NikitaSM5/FPGA_Automotive_Radar/(list of files, drawings)

Other design files:
Altium design/ADC.SchDoc
Altium design/Flash.SchDoc
Altium design/FPGA.SchDoc
Altium design/FPGA_Automotibe_Radar_Lib.SchLib
Altium design/FPGA_Automotive_Radar.PrjPcb
Altium design/FPGA_Automotive_Radar_PcbLib.PcbLib
Altium design/PCB2.PcbDoc
Altium design/PCB3.PcbDoc
Altium design/Power.SchDoc
