NikitaSM5/FPGA_Automotive_Radar/(commit log)

2025-09-28 PCB no traces
    [ADC.SchDoc, FPGA_Automotibe_Radar_Lib.SchLib, FPGA_Automotive_Radar_PcbLib.PcbLib, Flash.SchDoc, PCB3.PcbDoc, Power.SchDoc]
2025-09-28 Типа начал разводить
    [FPGA_Automotibe_Radar_Lib.SchLib, FPGA_Automotive_Radar_PcbLib.PcbLib, PCB3.PcbDoc, Power.SchDoc]
2025-09-28 Трассировка v1
    [PcbLib1.PcbLib]
2025-09-29 Трассировка v2
    [FPGA_Automotibe_Radar_Lib.SchLib, FPGA_Automotive_Radar_PcbLib.PcbLib, PCB3.PcbDoc, Power.SchDoc]
2025-10-03 Трассировка
    [ADC.SchDoc, FPGA_Automotibe_Radar_Lib.SchLib, FPGA_Automotive_Radar.PrjPcb, FPGA_Automotive_Radar_PcbLib.PcbLib, Flash.SchDoc, Power.SchDoc]
2025-10-14 Чертеж платы печатной
    [FPGA_Automotibe_Radar_Lib.SchLib, FPGA_Automotive_Radar.PrjPcb, Power.SchDoc]
